diosey/EEG_Prototype/Hardware/EEG_VER_1_Screenshots_Eeschema/Captura de pantalla 2026-09-04 233457.png

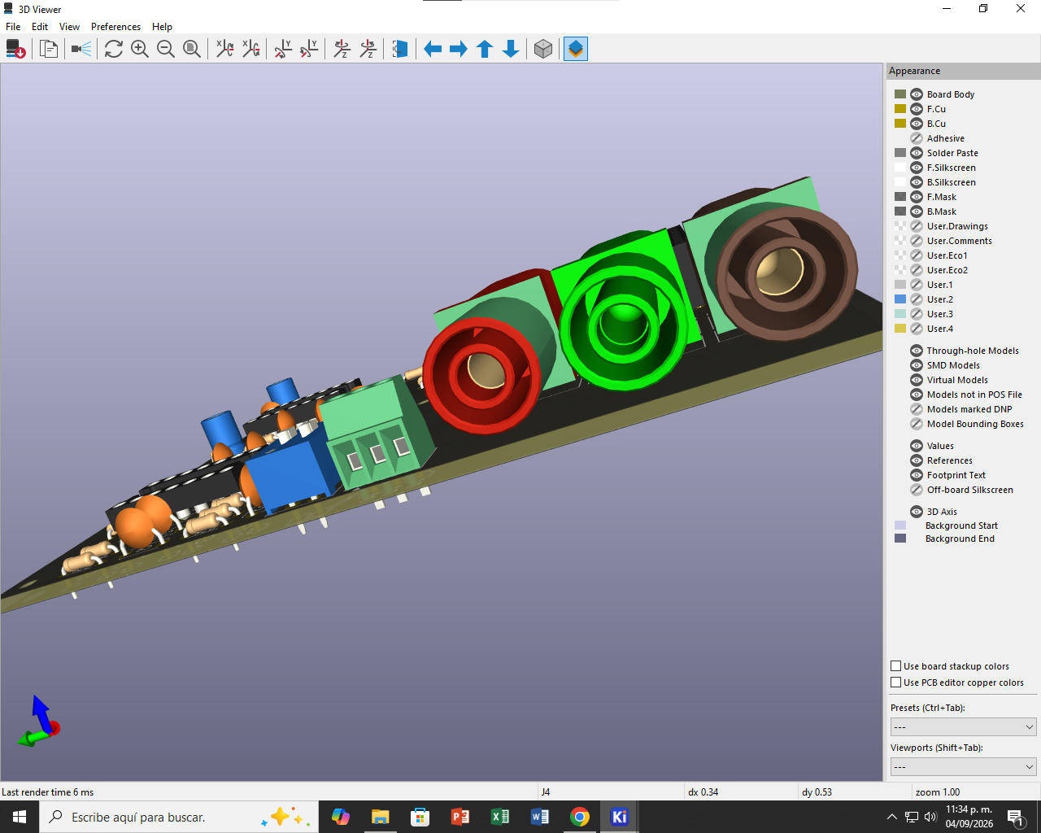
Hardware/EEG_VER_1_Screenshots_Eeschema/Captura de pantalla 2026-09-04 233457.png
