diosey/EEG_Prototype/Docs/DDB_EEG.jpg

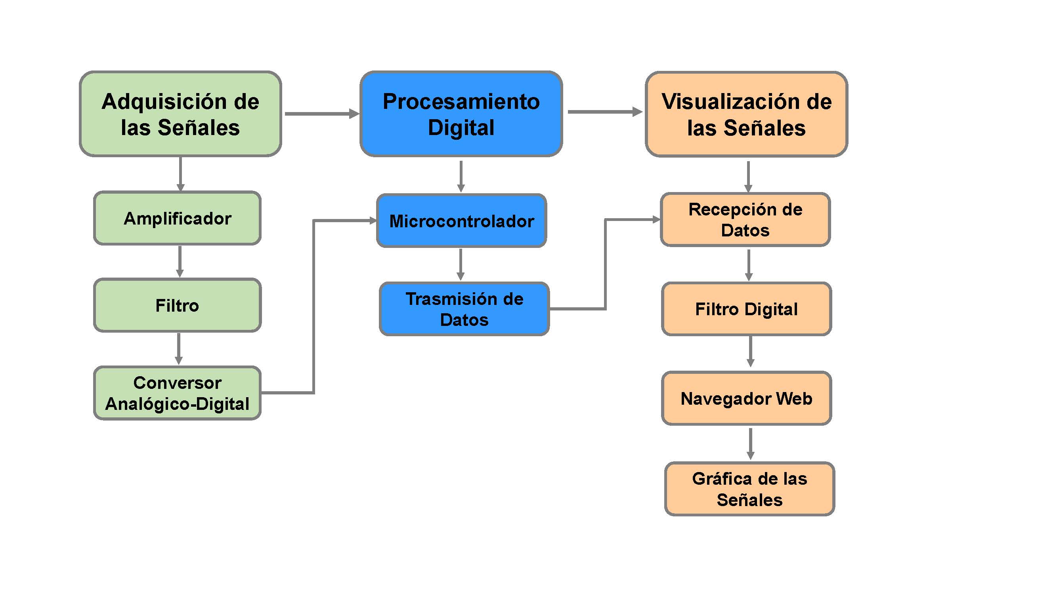
Docs/DDB_EEG.jpg
