diosey/EEG_Prototype/Hardware/EEG_VER_1_Screenshots_Eeschema/Captura de pantalla 2026-09-04 233642.png

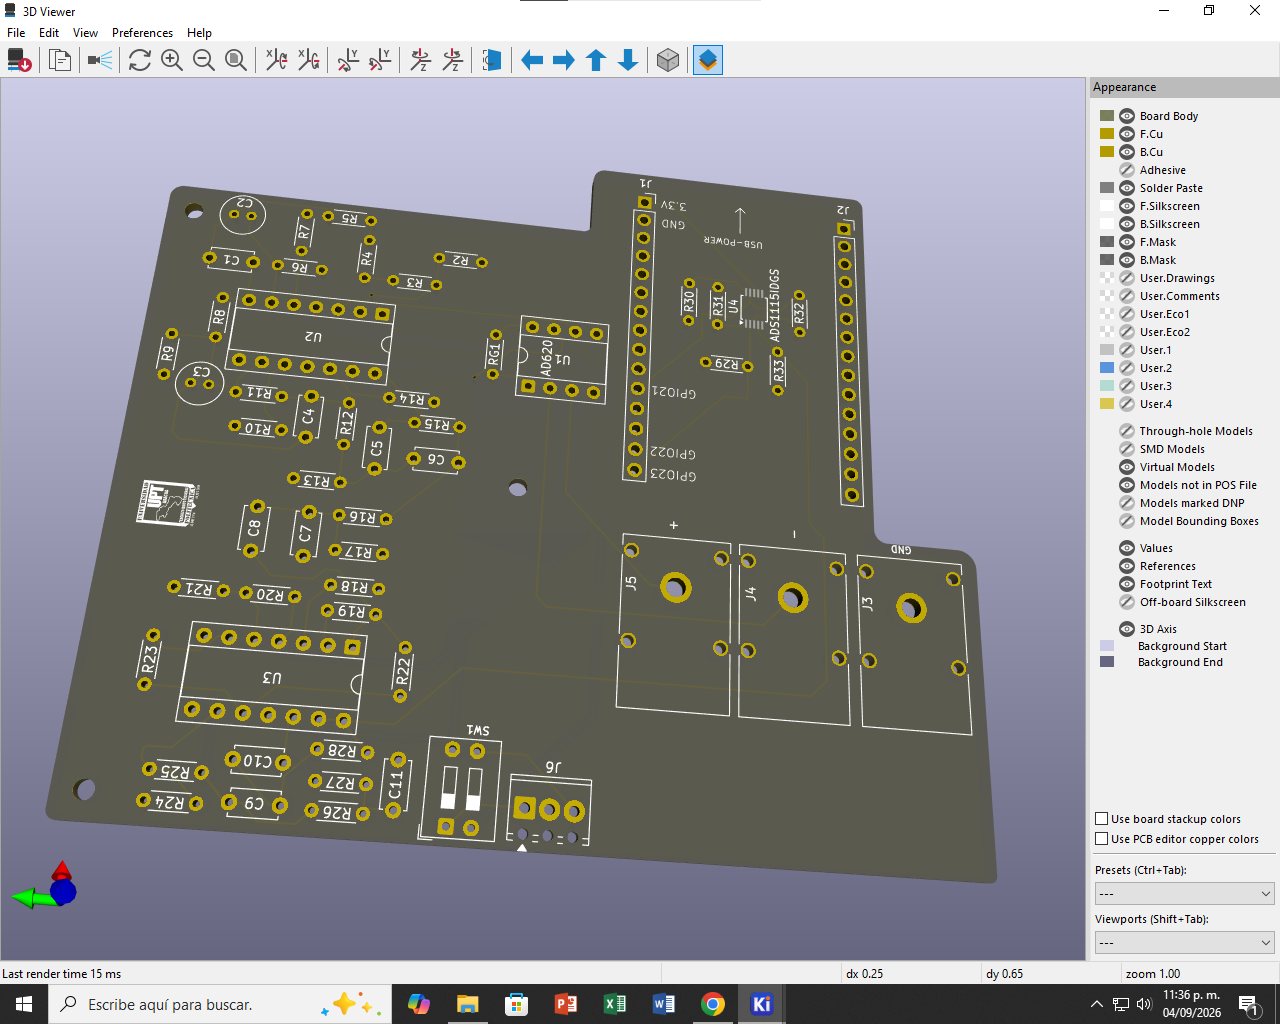
Hardware/EEG_VER_1_Screenshots_Eeschema/Captura de pantalla 2026-09-04 233642.png
