diosey/EEG_Prototype/PCB_VER_1_Screenshots/Captura de pantalla 2026-09-04 234050.png

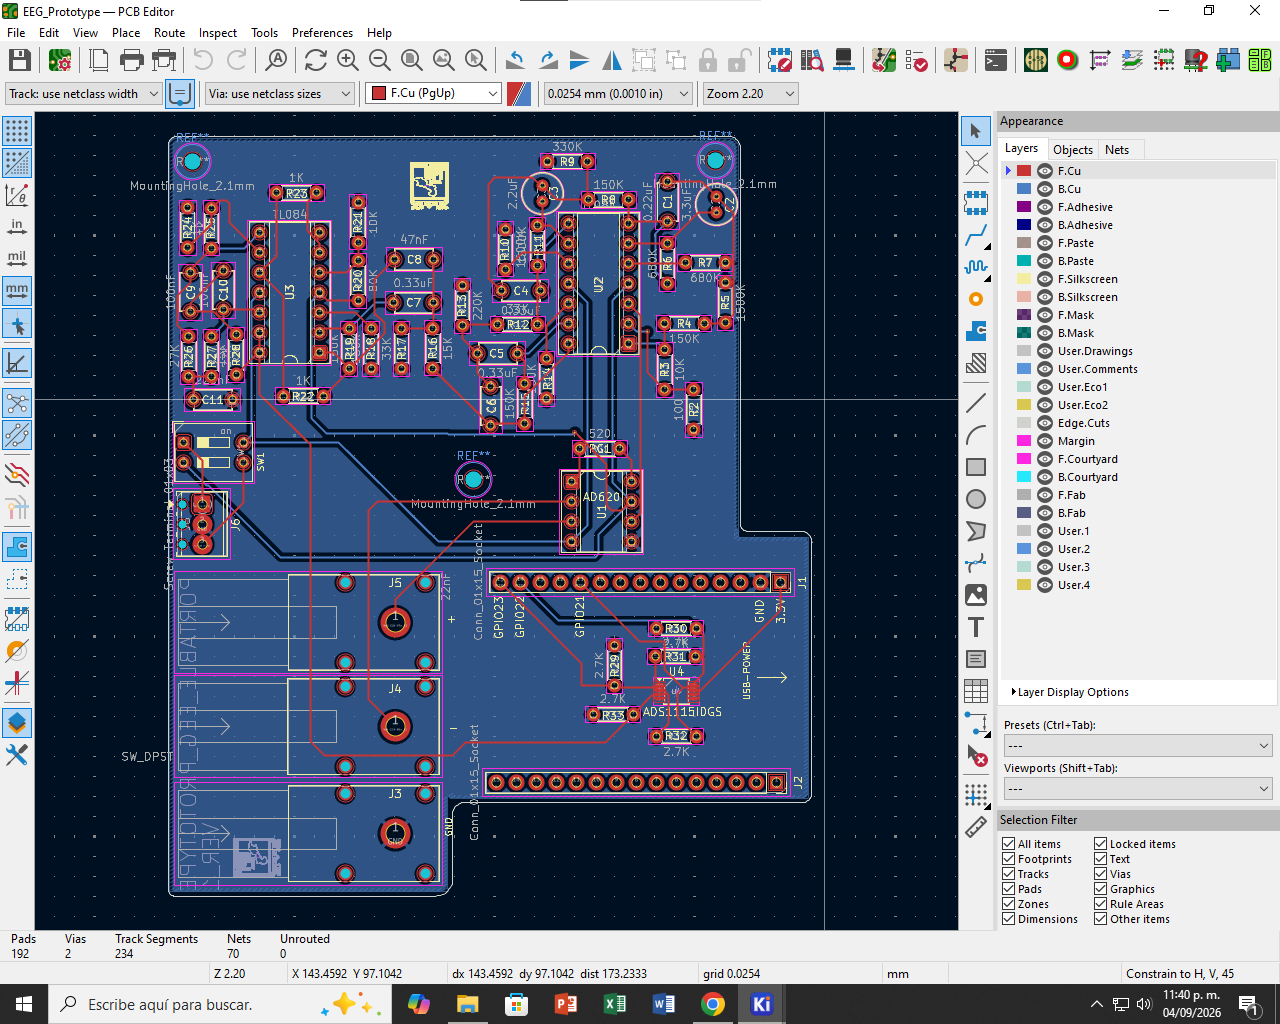
PCB_VER_1_Screenshots/Captura de pantalla 2026-09-04 234050.png
