diosey/EEG_Prototype/Hardware/EEG_VER_1_Screenshots_Eeschema/EEG_Eeschema.pdf

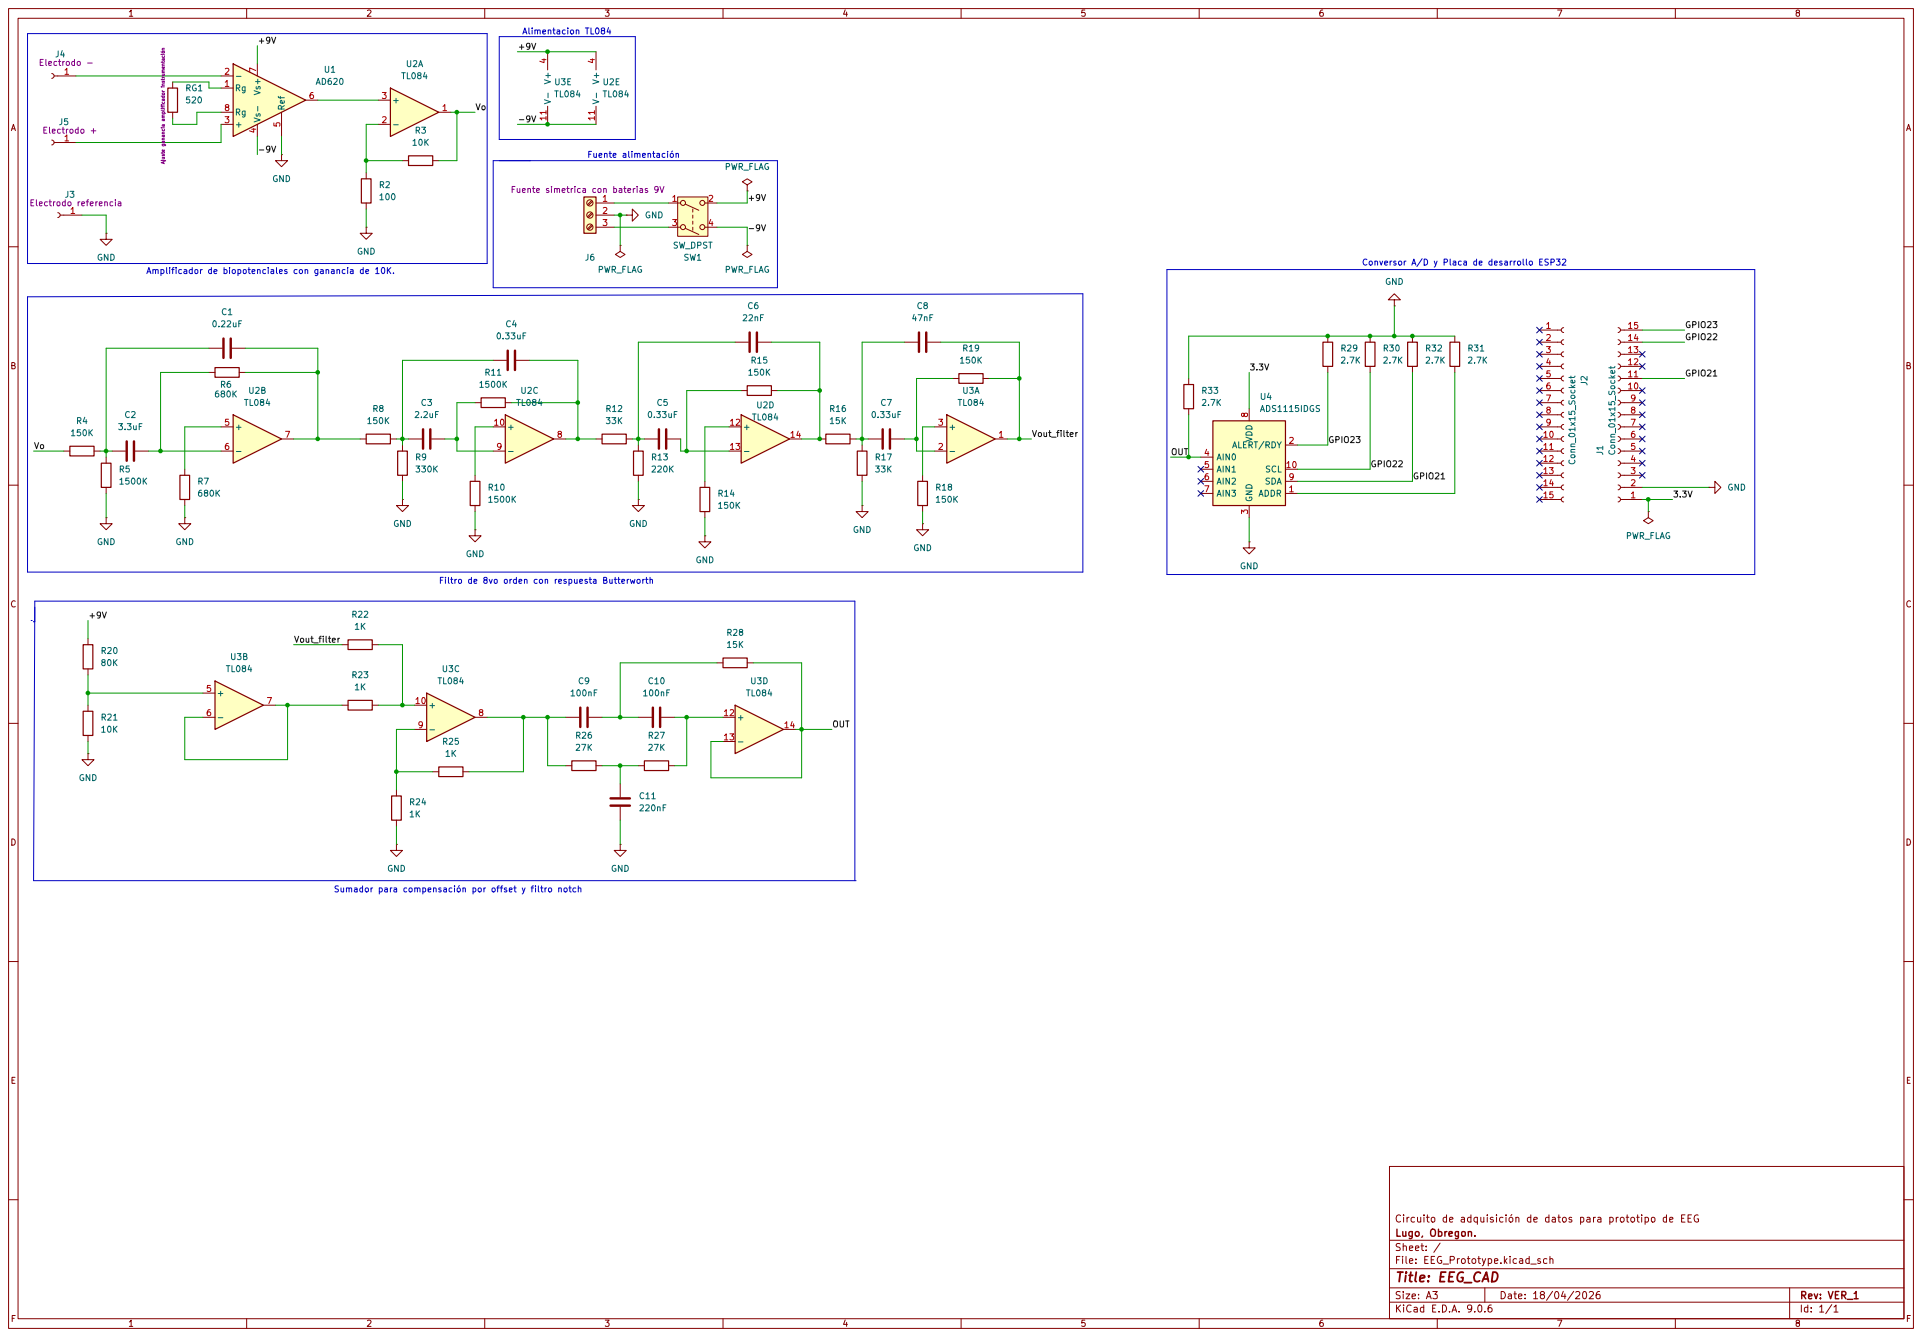
[picture p45: page 1]
