diosey/EEG_Prototype/Hardware/EEG_Prototype.kicad_pcb

## KiCad design Hardware/EEG_Prototype.kicad_pcb (2026-10-11)

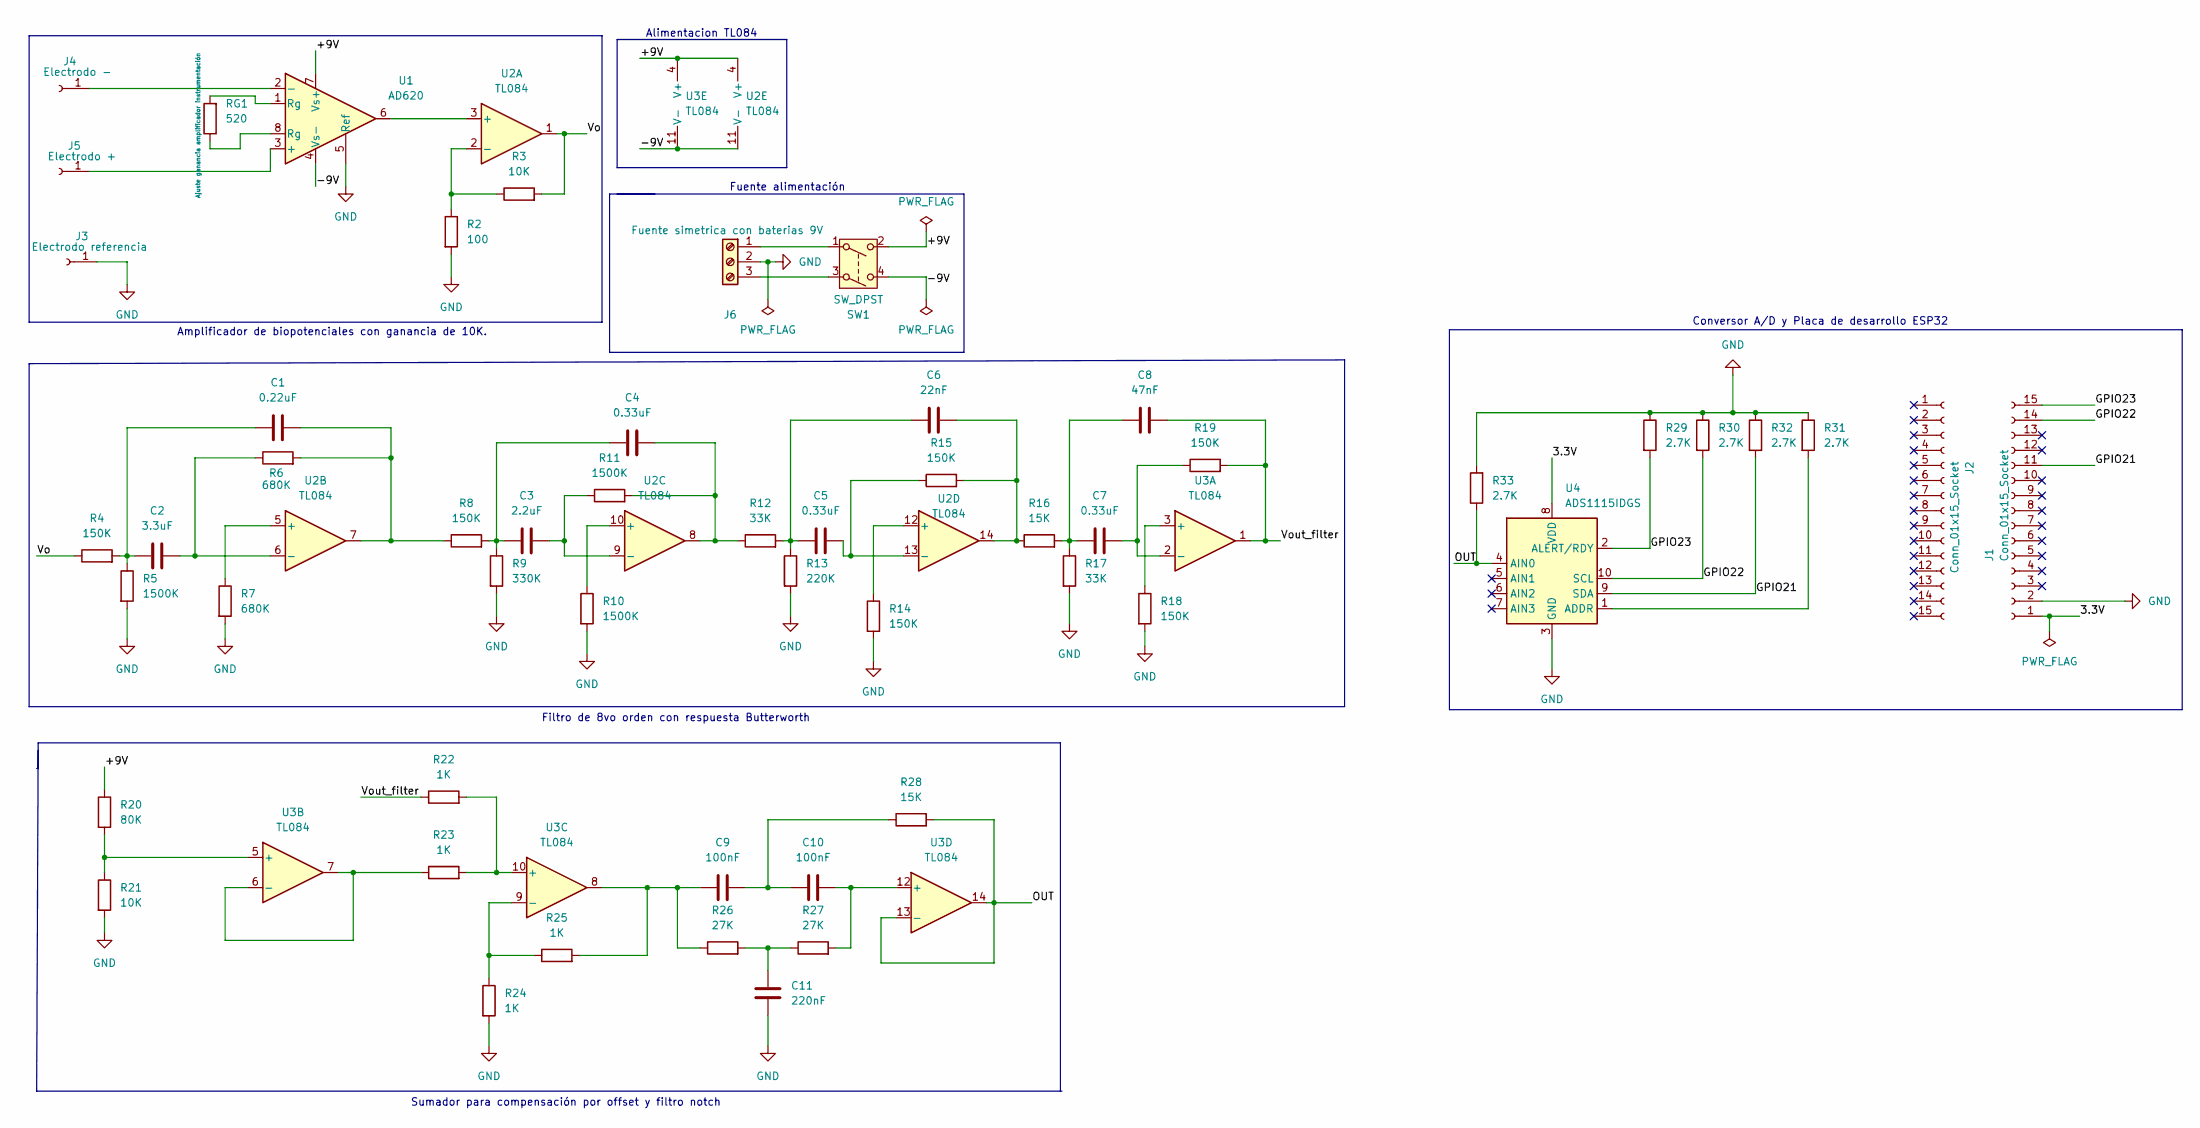
[picture p46: schematic EEG_Prototype.kicad_sch, EEG_CAD]

Parts:
C1: 0.22uF; C_Disc_D4.7mm_W2.5mm_P5.00mm
C2: 3.3uF; C_Radial_D5.0mm_H7.0mm_P2.00mm
C3: 2.2uF; C_Radial_D5.0mm_H7.0mm_P2.00mm
C4, C5, C7: 0.33uF; C_Disc_D4.7mm_W2.5mm_P5.00mm
C6: 22nF; C_Disc_D4.7mm_W2.5mm_P5.00mm
C8: 47nF; C_Disc_D4.7mm_W2.5mm_P5.00mm
C9, C10: 100nF; C_Disc_D4.7mm_W2.5mm_P5.00mm
C11: 220nF; C_Disc_D4.7mm_W2.5mm_P5.00mm
J1, J2: Conn_01x15_Socket; PinSocket_1x15_P2.54mm_Vertical
J3: Conn_01x01_Socket; Banana_Cliff_FCR7350N_S16N-PC_Horizontal
J4: Conn_01x01_Socket; Banana_Cliff_FCR7350B_S16N-PC_Horizontal
J5: Conn_01x01_Socket; Banana_Cliff_FCR7350R_S16N-PC_Horizontal
J6: Screw_Terminal_01x03; TerminalBlock_Phoenix_MPT-0,5-3-2.54_1x03_P2.54mm_Horizontal
R2: 100; R_Axial_DIN0204_L3.6mm_D1.6mm_P5.08mm_Horizontal
R3, R21: 10K; R_Axial_DIN0204_L3.6mm_D1.6mm_P5.08mm_Horizontal
R4, R8, R14, R15, R18, R19: 150K; R_Axial_DIN0204_L3.6mm_D1.6mm_P5.08mm_Horizontal
R5, R10, R11: 1500K; R_Axial_DIN0204_L3.6mm_D1.6mm_P5.08mm_Horizontal
R6, R7: 680K; R_Axial_DIN0204_L3.6mm_D1.6mm_P5.08mm_Horizontal
R9: 330K; R_Axial_DIN0204_L3.6mm_D1.6mm_P5.08mm_Horizontal
R12, R17: 33K; R_Axial_DIN0204_L3.6mm_D1.6mm_P5.08mm_Horizontal
R13: 220K; R_Axial_DIN0204_L3.6mm_D1.6mm_P5.08mm_Horizontal
R16, R28: 15K; R_Axial_DIN0204_L3.6mm_D1.6mm_P5.08mm_Horizontal
R20: 80K; R_Axial_DIN0204_L3.6mm_D1.6mm_P5.08mm_Horizontal
R22, R23, R24, R25: 1K; R_Axial_DIN0204_L3.6mm_D1.6mm_P5.08mm_Horizontal
R26, R27: 27K; R_Axial_DIN0204_L3.6mm_D1.6mm_P5.08mm_Horizontal
R29, R30, R31, R32, R33: 2.7K; R_Axial_DIN0204_L3.6mm_D1.6mm_P5.08mm_Horizontal
RG1: 520; R_Axial_DIN0204_L3.6mm_D1.6mm_P5.08mm_Horizontal
SW1: SW_DPST; SW_DIP_SPSTx02_Slide_9.78x7.26mm_W7.62mm_P2.54mm
U1: AD620; DIP-8_W7.62mm_Socket
U2, U3: TL084; DIP-14_W7.62mm_Socket
U4: ADS1115IDGS; TSSOP-10_3x3mm_P0.5mm

Connections:
/3.3V: J1.1, U4.8 (VDD)
/+9V: R20.1, SW1.2, U1.7 (Vs+), U2.4 (V+), U3.4 (V+)
/-9V: SW1.4, U1.4 (Vs-), U2.11 (V-), U3.11 (V-)
/GPIO21: J1.11, R32.2, U4.9 (SDA)
/GPIO22: J1.14, R30.2, U4.10 (SCL)
/GPIO23: J1.15, R29.2, U4.2 (ALERT/RDY)
/OUT: R28.2, R33.1, U3.13 (-), U3.14, U4.4 (AIN0)
/Vo: R3.2, R4.1, U2.1
/Vout_filter: C8.2, R19.2, R22.1, U3.1
GND: C11.1, J1.2, J3.1, J6.2, R2.2, R5.2, R7.2, R9.2, R10.2, R13.2, R14.2, R17.2, R18.2, R21.2, R24.2, R29.1, R30.1, R31.1, R32.1, R33.2, U1.5 (Ref), U4.3 (GND)
unnamed: C1.1, C2.1, R4.2, R5.1
unnamed: C1.2, R6.2, R8.1, U2.7
unnamed: C3.1, C4.1, R8.2, R9.1
unnamed: C4.2, R11.2, R12.1, U2.8
unnamed: C5.1, C6.1, R12.2, R13.1
unnamed: C6.2, R15.2, R16.1, U2.14
unnamed: C7.1, C8.1, R16.2, R17.1
unnamed: C9.1, R25.2, R26.1, U3.8
unnamed: C9.2, C10.1, R28.1
unnamed: C11.2, R26.2, R27.1
unnamed: J4.1, U1.2 (-)
unnamed: J5.1, U1.3 (+)
unnamed: J6.1, SW1.1
unnamed: J6.3, SW1.3
unnamed: RG1.1, U1.8 (Rg)
unnamed: RG1.2, U1.1 (Rg)
unnamed: U1.6, U2.3 (+)
unnamed: R2.1, R3.1, U2.2 (-)
unnamed: R7.1, U2.5 (+)
unnamed: C2.2, R6.1, U2.6 (-)
unnamed: R10.1, U2.10 (+)
unnamed: C3.2, R11.1, U2.9 (-)
unnamed: R14.1, U2.12 (+)
unnamed: C5.2, R15.1, U2.13 (-)
unnamed: R18.1, U3.3 (+)
unnamed: C7.2, R19.1, U3.2 (-)
unnamed: R20.2, R21.1, U3.5 (+)
unnamed: R23.1, U3.6 (-), U3.7
unnamed: R22.2, R23.2, U3.10 (+)
unnamed: R24.1, R25.1, U3.9 (-)
unnamed: C10.2, R27.2, U3.12 (+)
unnamed: R31.2, U4.1 (ADDR)

Notes on the sheet:
Sumador para compensación por offset y filtro notch
Filtro de 8vo orden con respuesta Butterworth
Conversor A/D y Placa de desarrollo ESP32
Amplificador de biopotenciales con ganancia de 10K.
Fuente alimentación
Alimentacion TL084

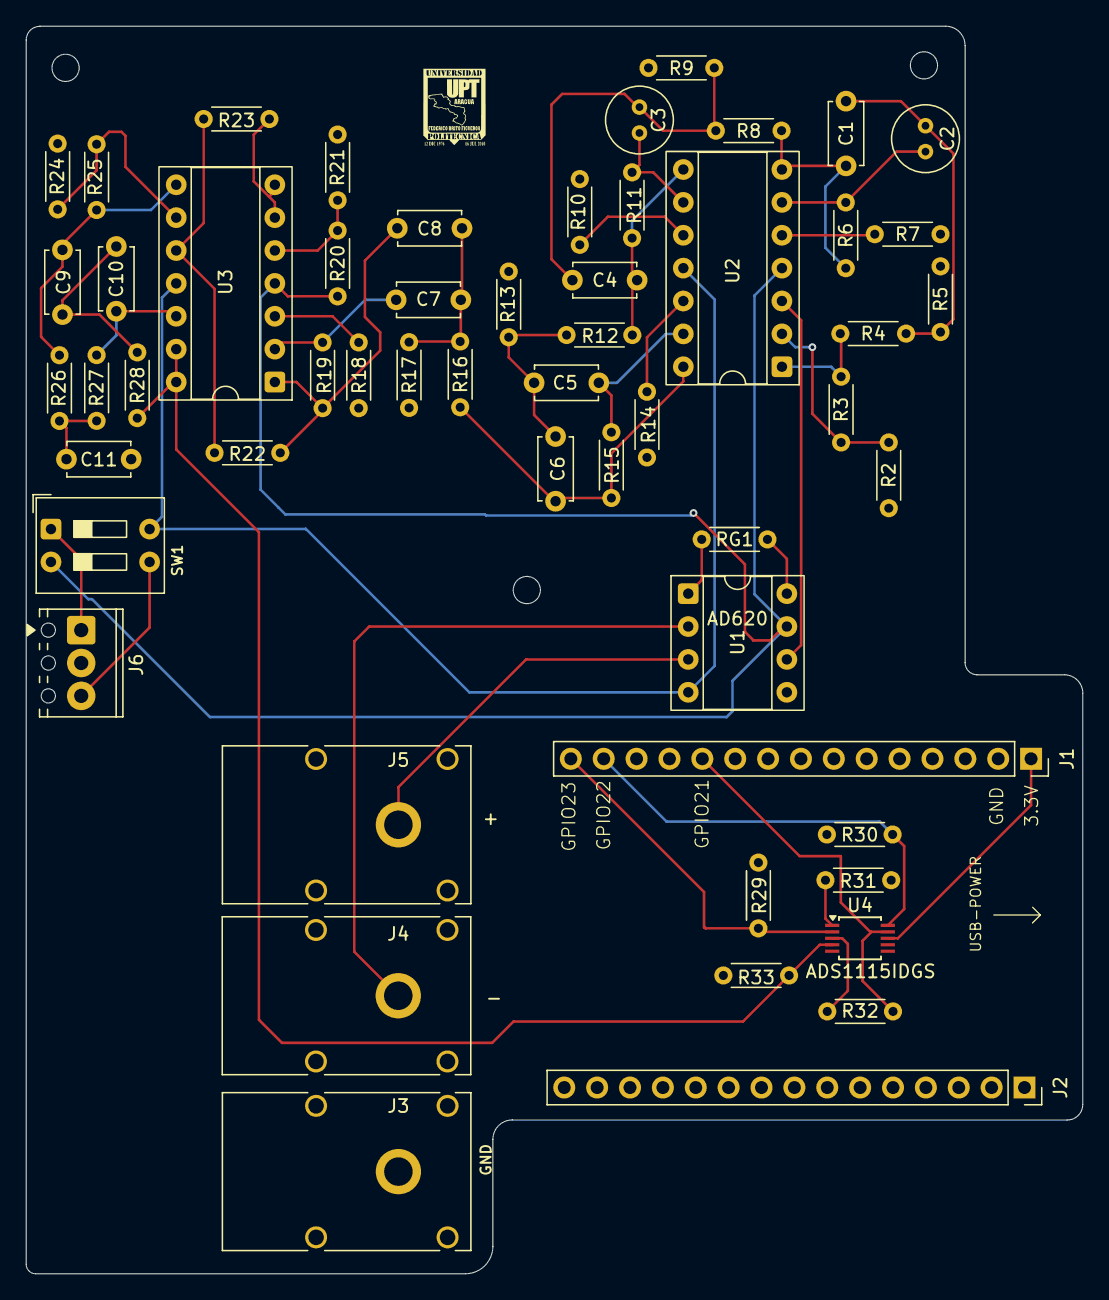
[picture p47: board EEG_Prototype.kicad_pcb from above]

Board: 2 copper layers, 81.6 x 96.4 mm, 55 parts (0 on the bottom side), 42 nets.
